VojtechNebes/ssps-stp-stenokeyboard/vystup_3/pictures/assembled_body.jpg

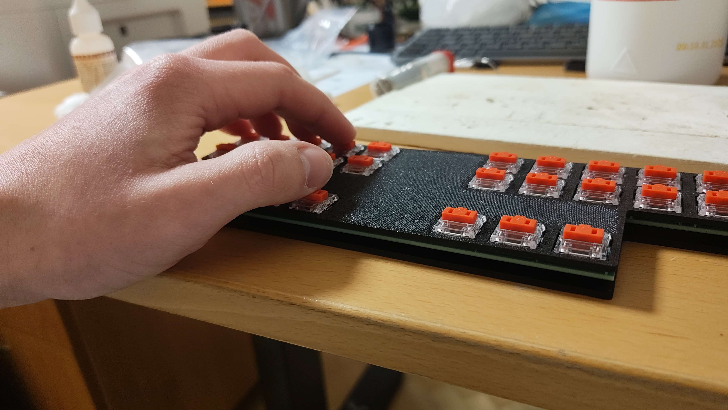
vystup_3/pictures/assembled_body.jpg
