VojtechNebes/ssps-stp-stenokeyboard/vystup_3/pictures/print_done.jpg

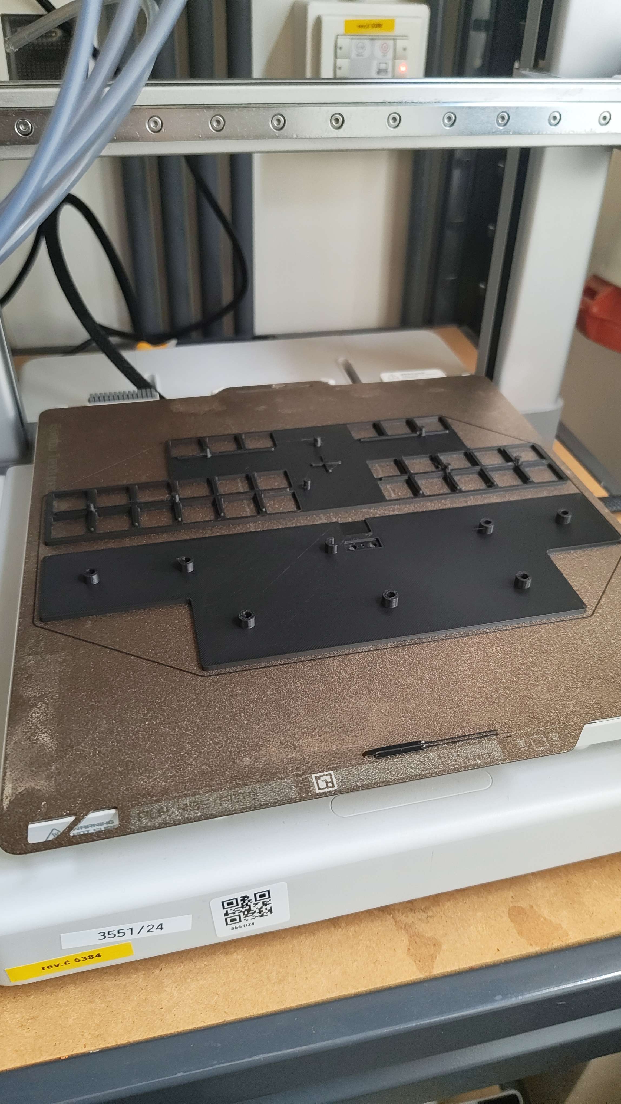
vystup_3/pictures/print_done.jpg
