VojtechNebes/ssps-stp-stenokeyboard/vystup_1/STP výstup 1.pptx

## Stenokeyboard

Výstup 1
Vojtěch Nebes, 3. A

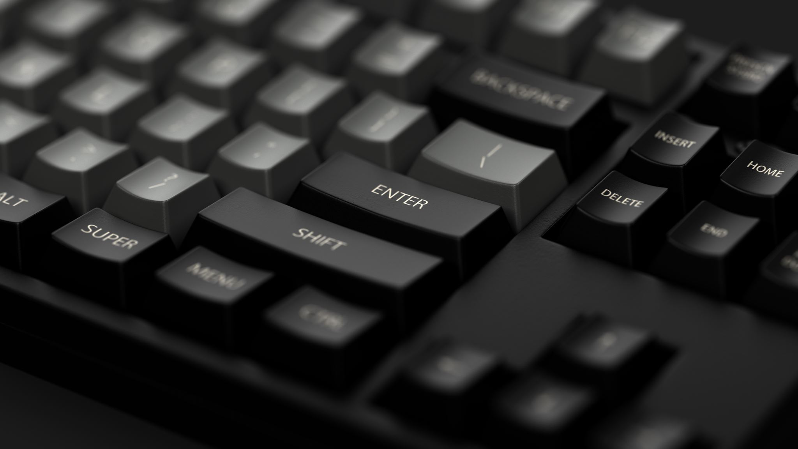
[picture p3: figure]
Closeup of a keyboard

## Obsah prvního výstupu

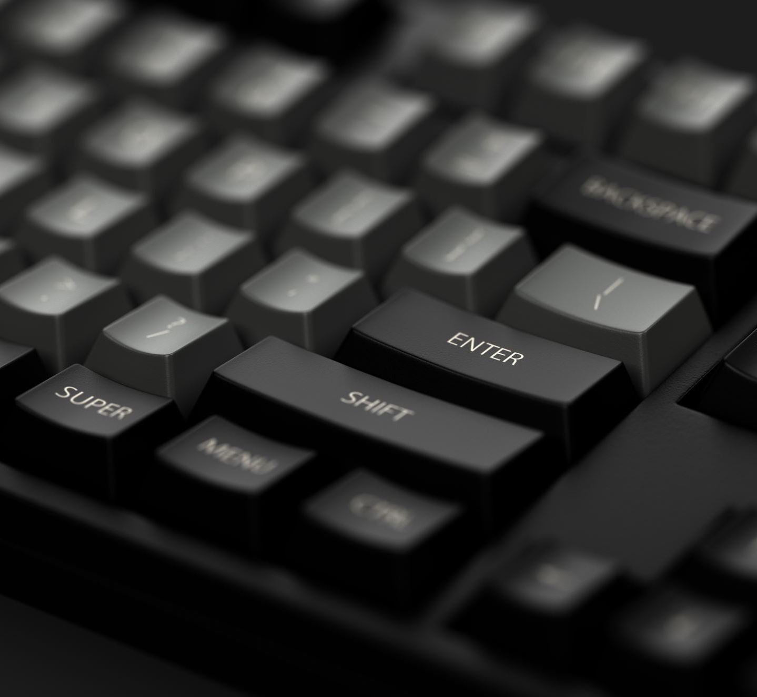
[picture p4: figure]
Closeup of a keyboard

- Nákup součástek
  - Mikrokontroler
  - Spínače
- TinyUSB prototyp
- PCB - EasyEDA

## Mikrokontroler – srdce klávesnice

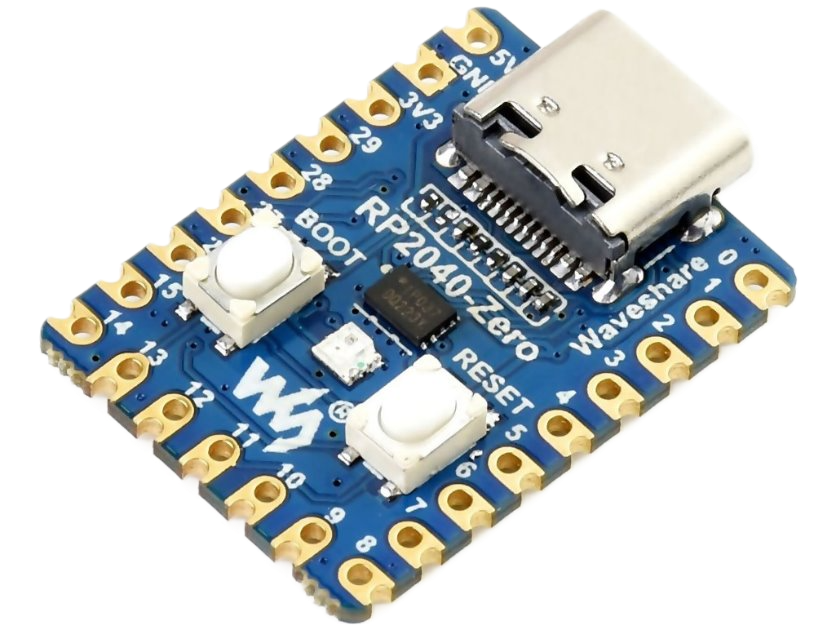
[picture p5: figure]
RP2040-Zero Module with RP2040, 2MB Flash, USB Type C - 99Tech

## Mechanické nízkoprofilové spínače

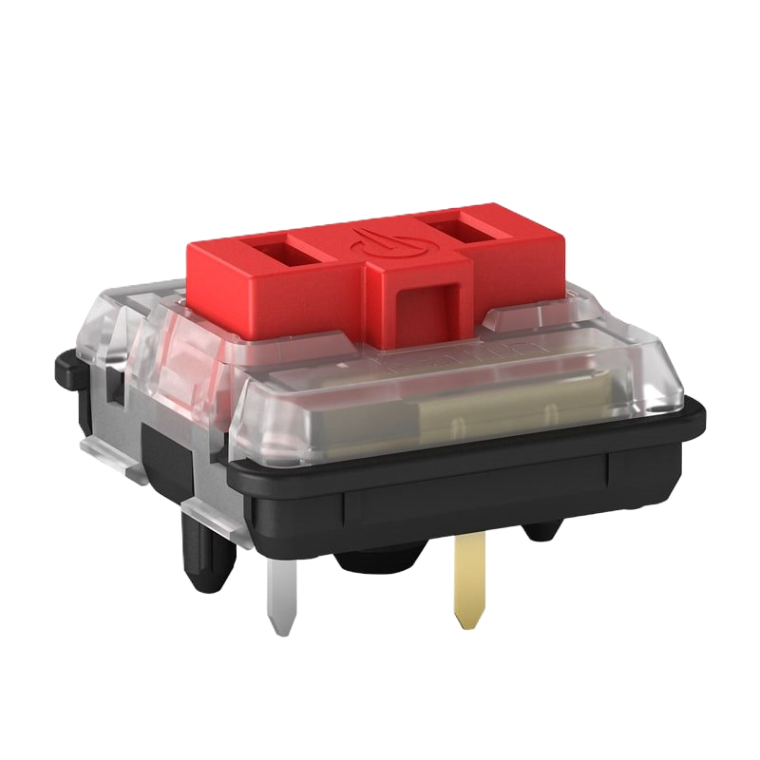
[picture p6: figure]
Kailh Low Profile Choc Switches V1 | Red | KC10034_RE

## Firmware

main.c

send_word("Hello world!\0")

my_hid.h

1. Shift H
2. E L
3. L O Space W
4. O R L D
5. Shift 1

tusb.h

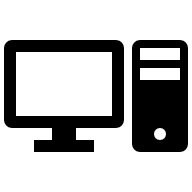
[picture p7: figure]
Computer with solid fill

## Slide 6

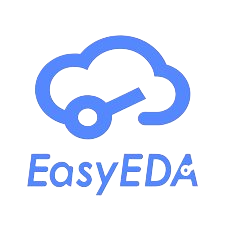
[picture p8: figure]
EasyEDA - YouTube
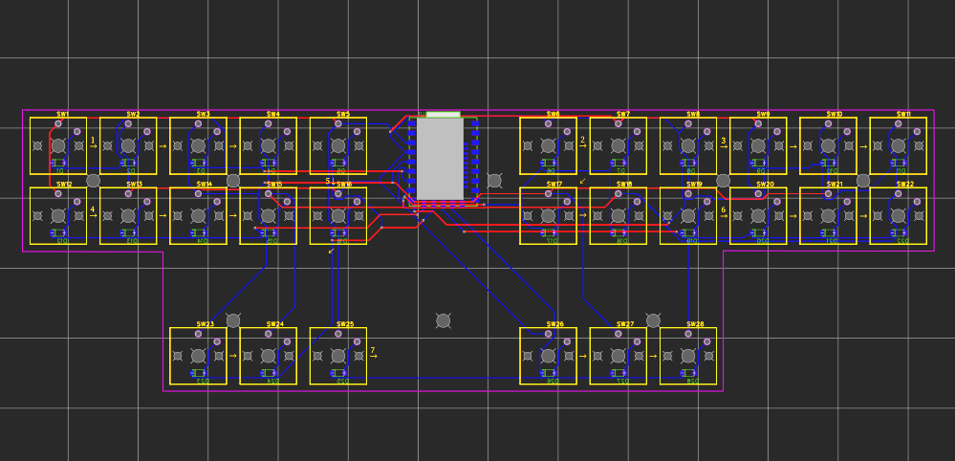
[picture p9: figure]

## Slide 7

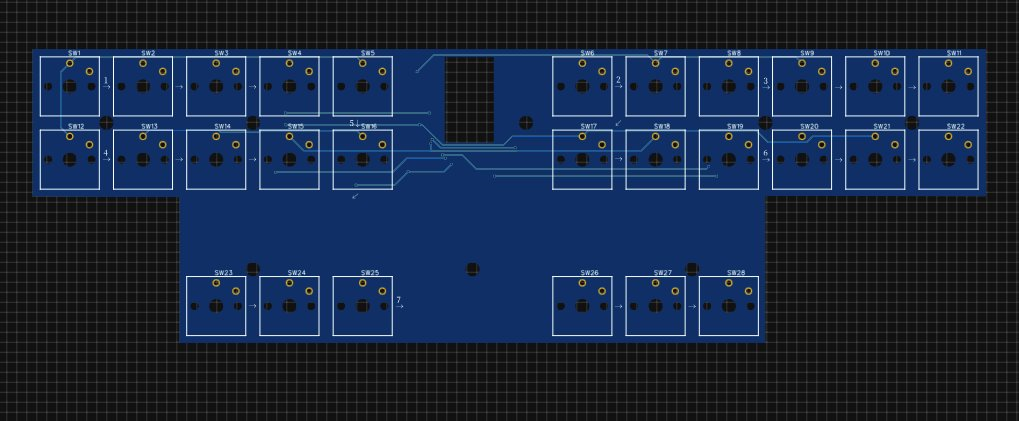
[picture p10: figure]
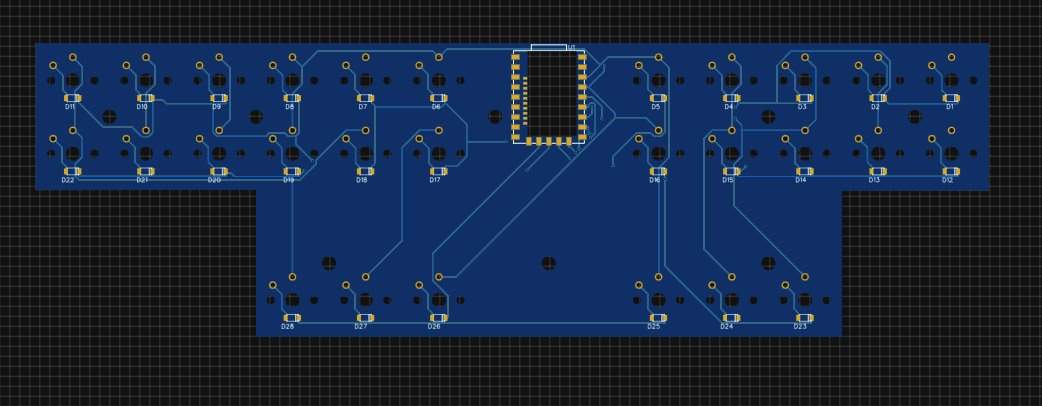
[picture p11: figure]
