VojtechNebes/ssps-stp-stenokeyboard/vystup_4/STP výstup 4.pptx

## Stenokeyboard

Výstup 4
Vojtěch Nebes, 3. A

Closeup of a keyboard

## Teorie

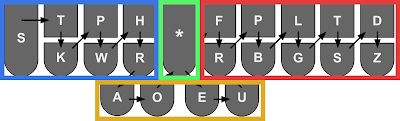
[picture p12: figure]

KAT -> "cat"

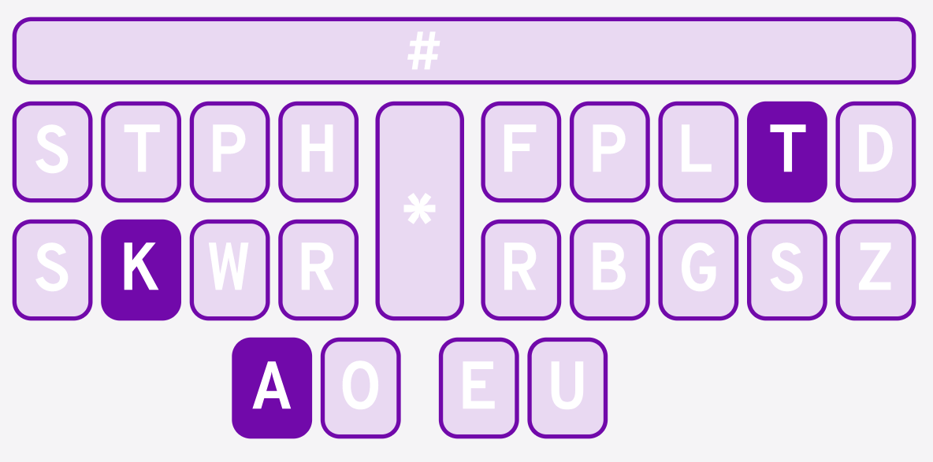
[picture p13: figure]

TKA

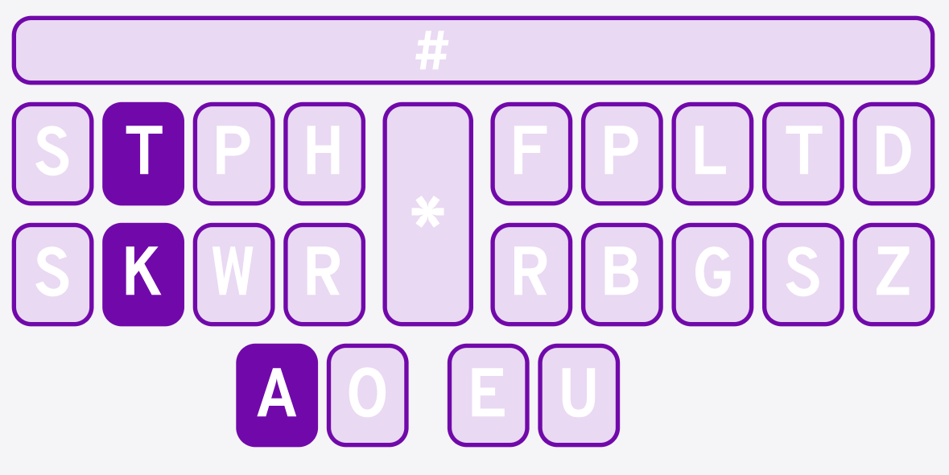
[picture p14: figure]

## Akordy

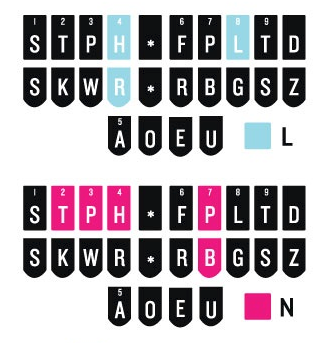
[picture p15: figure]

"long"

O

-PB

HR

-G

HRO-PBG

## Firmware???

0 1 2 3 16 4 5 8 9 10 11
12 13 14 15 17 6 7 20 21 22 23
18 19 24 26 27 28

29b 0=12, 18=28, ... 23b 3B

## Firmware???

uint_8t* hw_keyboard_scan();

chord_state: 00000000 00100100 01000000
chord_state: 00000000 00100100 00000000
+
key_state: 00000000 00000000 01000000

key_state: 00000000 00000000 01000000

## Slide 6

bool is_keyboard_empty();

true

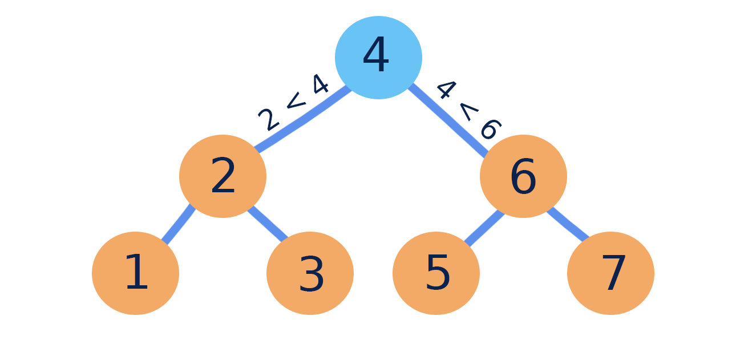
[picture p16: figure]
CS 225 | Binary Search Trees

00000000 00100100 01000000 01100011 01100001 01110100 \0 \0 \0 \0 \0 \0 \0 \0 \0 \0 \0 \0 \0 \0 \0

c

KAT

a

t

## Slide 7

void process_write(...);

## Sekvence

KPHEPBLT

"comment"

KPHEPBLT/TAER

"commentary"

SPWR/TKEUS/PHREUPB/AER

"interdisciplinary"

## py generate_dict

- JSON

{
"-T": "the",
"TO": "to",
"KAT": "cat"
}

- Binary

00000000: 40 80 00 74 6f 00 @..to.
00000006: 09 02 00 63 61 74 ...cat
0000000c: 00 02 00 74 68 65 ...the

Akord -T

"the"
