VojtechNebes/ssps-stp-stenokeyboard/vystup_2/Dokumentace výstupu 2.pdf

Smíchovská střední průmyslová škola a gymnázium – školní rok 2025/2026

# Dokumentace výstupu

### Studentský projekt:

### Řešitel:

### Číslo výstupu:

### Datum odevzdání výstupu: Popis práce na výstupu:

(100-200 slov)

### Popis příloh, které jsou součástí výstupu:

### Odkaz na sdílené úložiště (pokud je):

### Pokyny:

Každý člen týmu vyplňuje formulář sám za sebe. Popisuje svoji práci tak, aby bylo zřejmé, co

### bylo náplní jeho práce na výstupu. Pokud se popis práce shoduje s jiným členem týmu, je

nutné vysvětlit, proč je práce shodná.

### Stenokeyboard Vojt ch Nebes 2

10. 12. 2025

### V p iloženém GitHub repozitá i se nachází tento dokument a p ípadné další soubory související s výstupem

### https://github.com/VojtechNebes/ssps-stp-stenokeyboard/tree/main/vystup_2

V rámci druhého výstupu jsem navrhl a na školní 3D tiskárn vytiskl klávesové krytky pro spína e na klávesnici. K návrhu jsem použil program Autocad Inventor 2025 a pro slicování program Bambu Studio. Tiskl jsem na tiskárn Bambulab A1 z materiálu PLA. Protože mi už p išlo objednané PCB a spína e, mohl jsem rovnou otestovat r zné rozm ry klávesových krytek. Jde hlavn o to, aby dob e držely ve spína ích a aby mezi nimi byly mezery tak akorát, abych na dotek poznal hranici mezi spína i, ale ne moc velké, aby šlo snadno zmá knout víc spínačů jedním prstem. Nakonec jsem použil velikost spína e 17.1mm a toleranci pro zasazení do spína e 0.2mm.
