VojtechNebes/ssps-stp-stenokeyboard/vystup_1/Dokumentace výstupu 1.pdf

Smíchovská střední průmyslová škola a gymnázium – školní rok 2025/2026

# Dokumentace výstupu

Studentský projekt:
Řešitel:
Číslo výstupu:
Datum odevzdání výstupu:
Popis práce na výstupu:

(100-200 slov)
Popis příloh, které jsou součástí výstupu:

Odkaz na sdílené úložiště (pokud je):

Pokyny:
Každý člen týmu vyplňuje formulář sám za sebe. Popisuje svoji práci tak, aby bylo zřejmé, co bylo náplní jeho práce na výstupu. Pokud se popis práce shoduje s jiným členem týmu, je nutné vysvětlit, proč je práce shodná.

Stenokeyboard
Vojtěch Nebes
1
20. 11. 2025

V přiloženém GitHub repozitáři se nachází tento dokument, kód a případné další soubory související s výstupem

https://github.com/VojtechNebes/ssps-stp-stenokeyboard/tree/main/vystup_1

V posledních pěti týdnech jsem:
- Koupil mikrokontroler RP2040-Zero z obchodu Laskakit a objednal spínače na klávesnici z Amazonu, konkrétně Kailh Choc V1 Red, nízkoprofilové mechanické spínače, které později připájím na PCB.
- Začal pracovat na firmwaru pro mikrokontroler a rozchodil prototyp využívající knihovnu TinyUSB. Prototyp se zatím chová tak, že mikrokontroler připojím k počítači pomocí USB C kabelu. Když poté drátkem vyskratuji konkrétní 2 GPIO piny (drátek bude později nahrazen spínačem klávesnice), na připojeném počítači se napíše řetězec "Hello world!".
- Navrhl PCB v programu EasyEda, nicméně tam ještě bude potřeba další práce, než ho pošlu k výrobě. Je třeba domyslet připevnění PCB k tělu klávesnice - jestli použiji šroubky, nebo lepidlo.
