VojtechNebes/ssps-stp-stenokeyboard/vystup_1/pictures/PCB_design.png

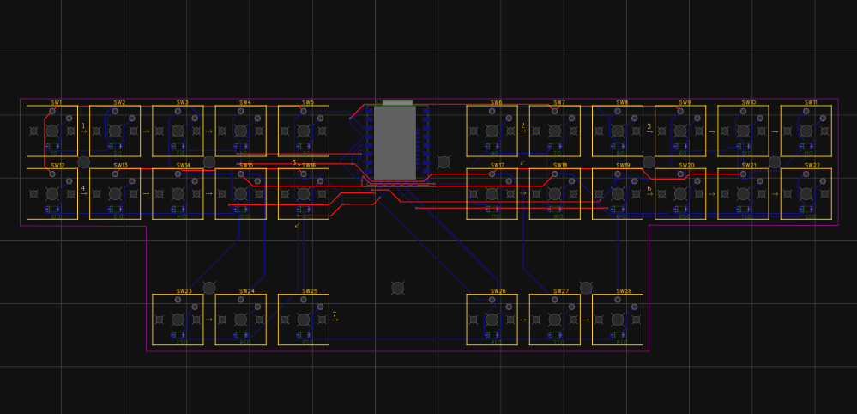
vystup_1/pictures/PCB_design.png
