VojtechNebes/ssps-stp-stenokeyboard/vystup_1/pictures/PCB_preview_top.png

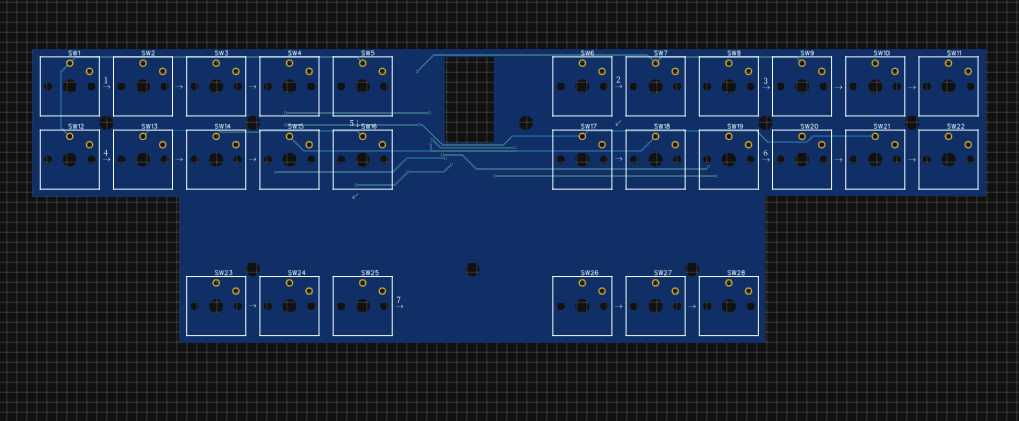
vystup_1/pictures/PCB_preview_top.png
