VojtechNebes/ssps-stp-stenokeyboard/vystup_2/pictures/key_in_pcb.jpg

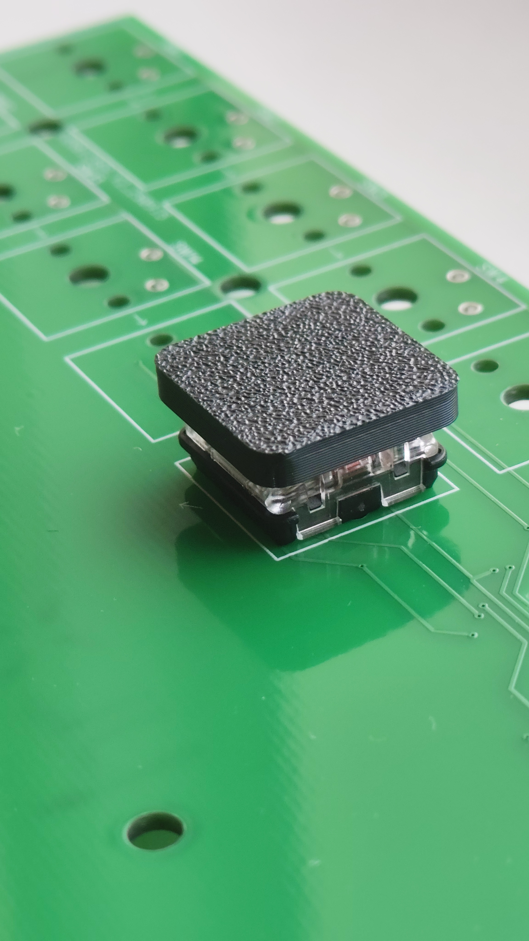
vystup_2/pictures/key_in_pcb.jpg
