VojtechNebes/ssps-stp-stenokeyboard/vystup_2/pictures/key_pressed.jpg

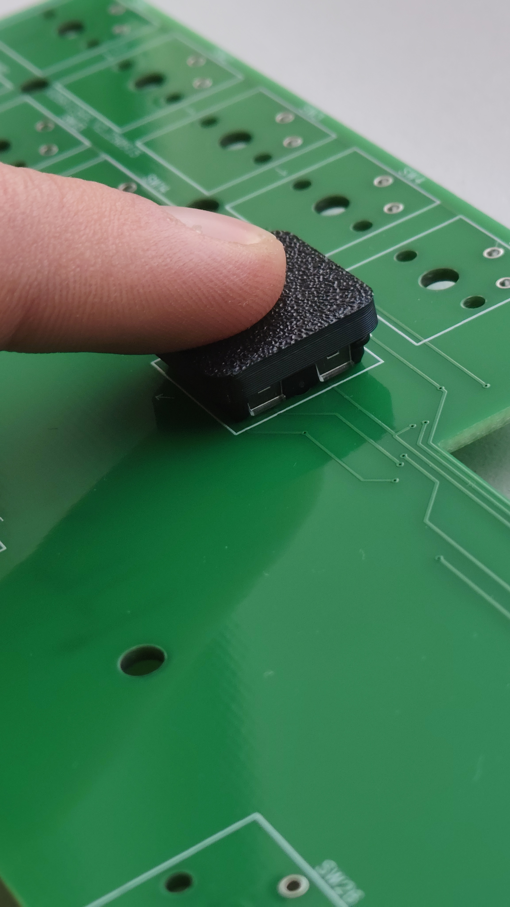
vystup_2/pictures/key_pressed.jpg
