VojtechNebes/ssps-stp-stenokeyboard/vystup_2/pictures/key_released.jpg

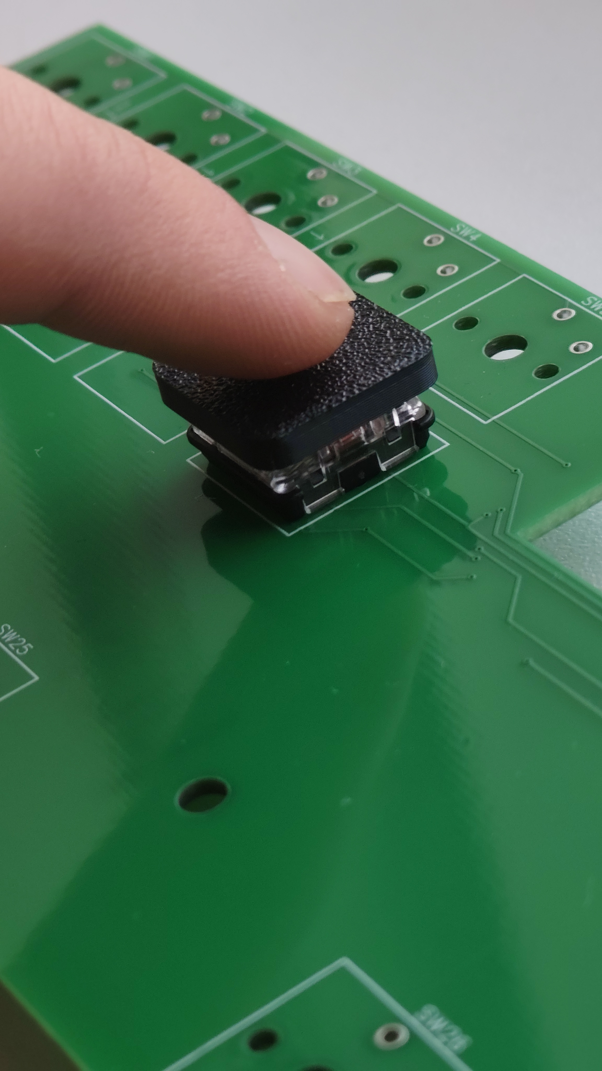
vystup_2/pictures/key_released.jpg
