VojtechNebes/ssps-stp-stenokeyboard/vystup_2/pictures/keycap_bottom.jpg

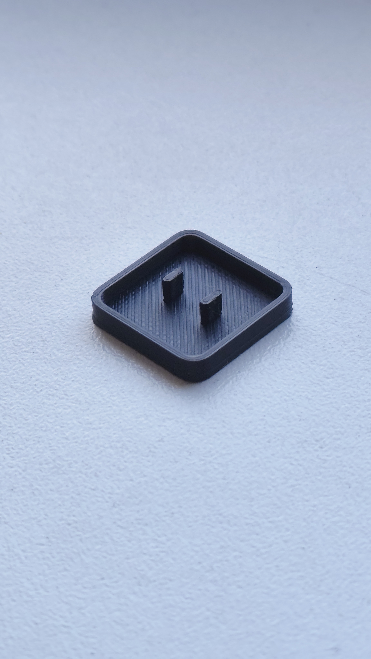
vystup_2/pictures/keycap_bottom.jpg
