VojtechNebes/ssps-stp-stenokeyboard/vystup_2/pictures/keycap_inventor.png

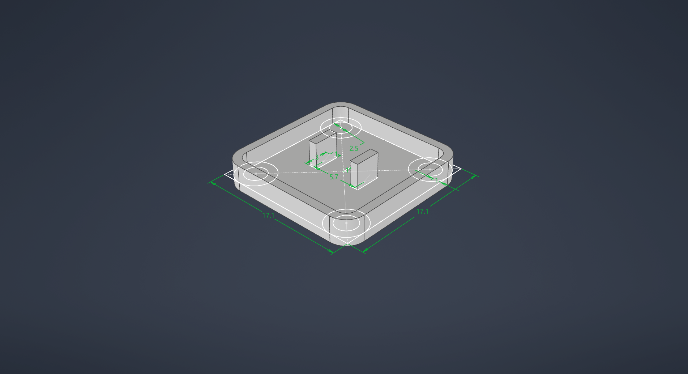
vystup_2/pictures/keycap_inventor.png
