VojtechNebes/ssps-stp-stenokeyboard/vystup_2/pictures/keycap_on_switch.jpg

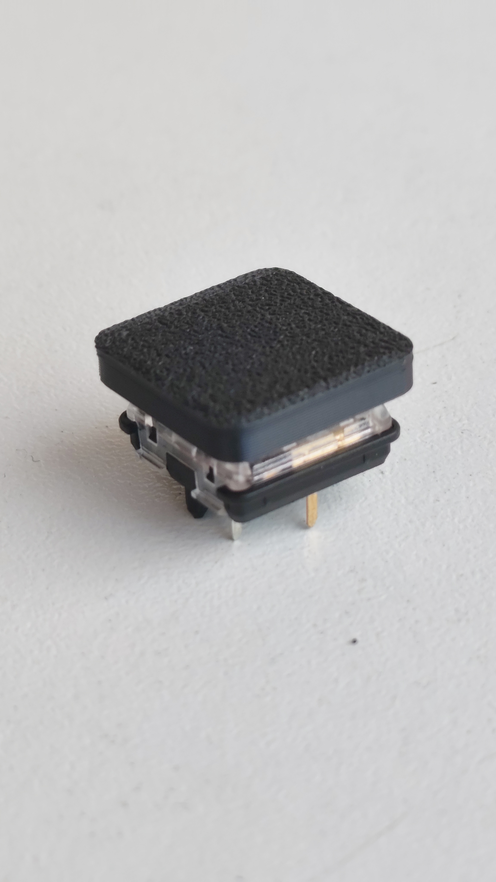
vystup_2/pictures/keycap_on_switch.jpg
