VojtechNebes/ssps-stp-stenokeyboard/vystup_2/pictures/keycap_slicer.png

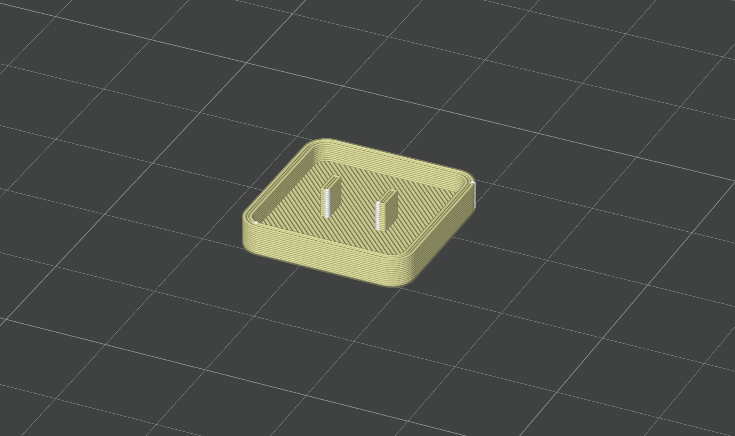
vystup_2/pictures/keycap_slicer.png
