VojtechNebes/ssps-stp-stenokeyboard/vystup_2/pictures/keycap_top.jpg

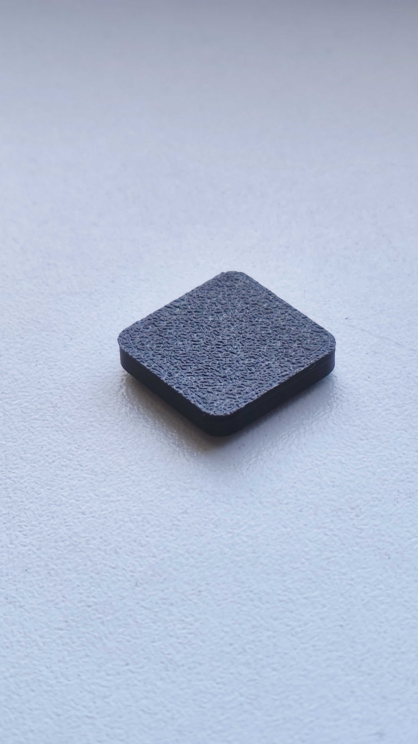
vystup_2/pictures/keycap_top.jpg
