VojtechNebes/ssps-stp-stenokeyboard/vystup_2/pictures/pcb_bottom.jpg

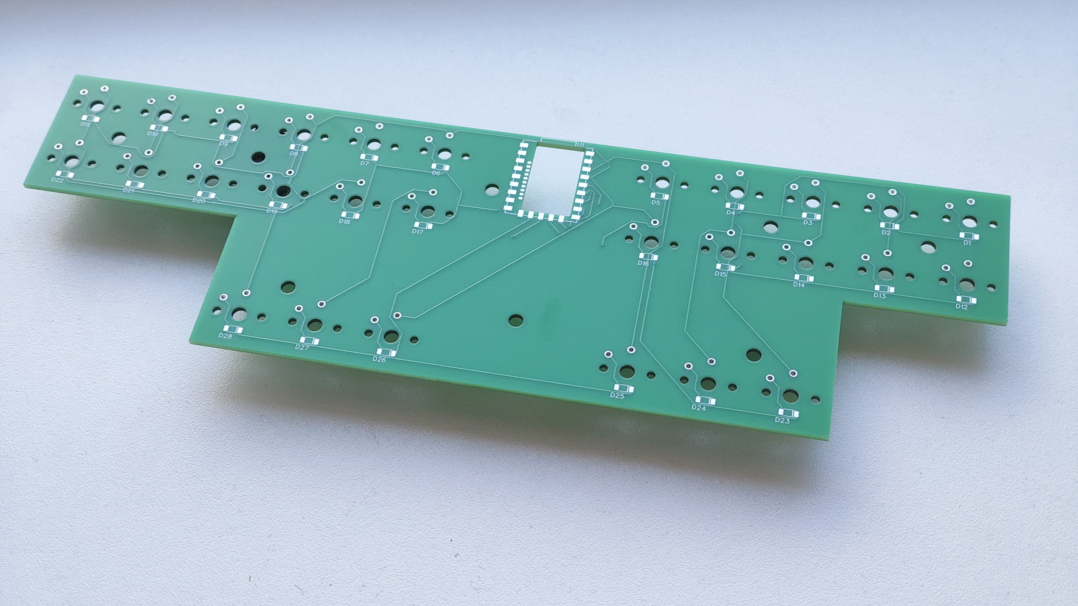
vystup_2/pictures/pcb_bottom.jpg
