VojtechNebes/ssps-stp-stenokeyboard/vystup_2/pictures/pcb_close_up.jpg

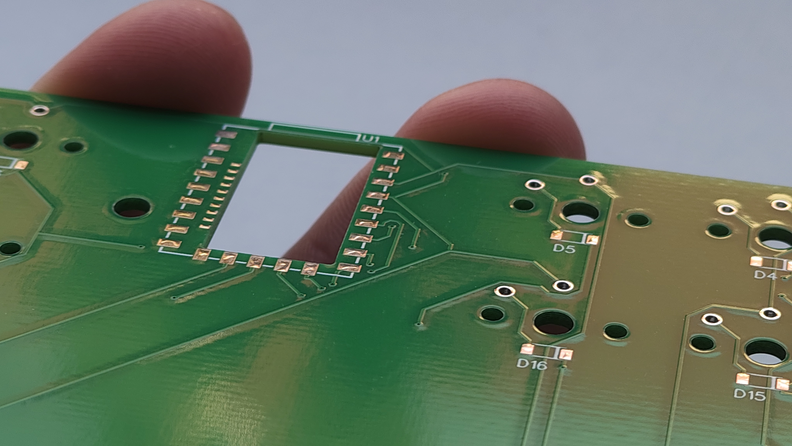
vystup_2/pictures/pcb_close_up.jpg
