VojtechNebes/ssps-stp-stenokeyboard/vystup_2/pictures/pcb_top.jpg

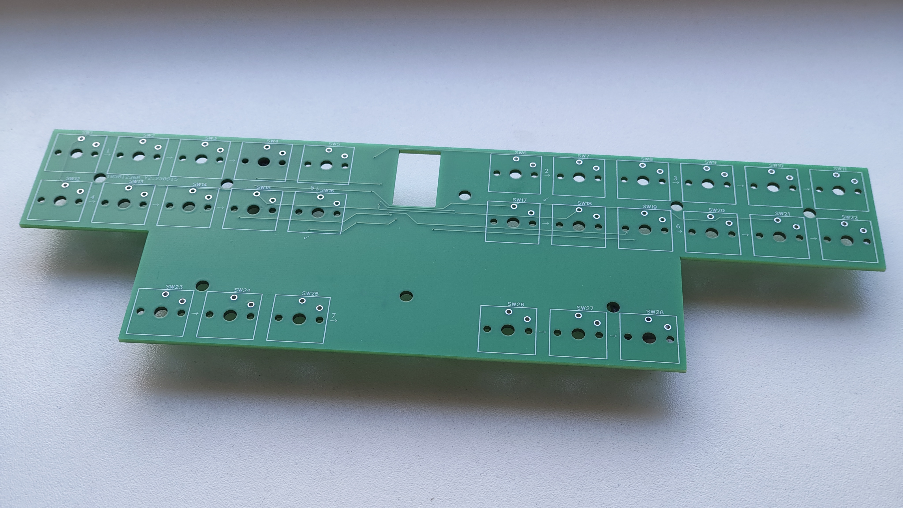
vystup_2/pictures/pcb_top.jpg
