VojtechNebes/ssps-stp-stenokeyboard/vystup_2/pictures/switch.jpg

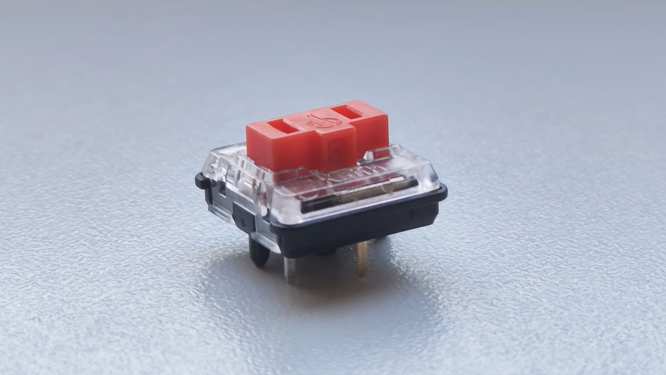
vystup_2/pictures/switch.jpg
