VojtechNebes/ssps-stp-stenokeyboard/vystup_2/pictures/switch_in_pcb.jpg

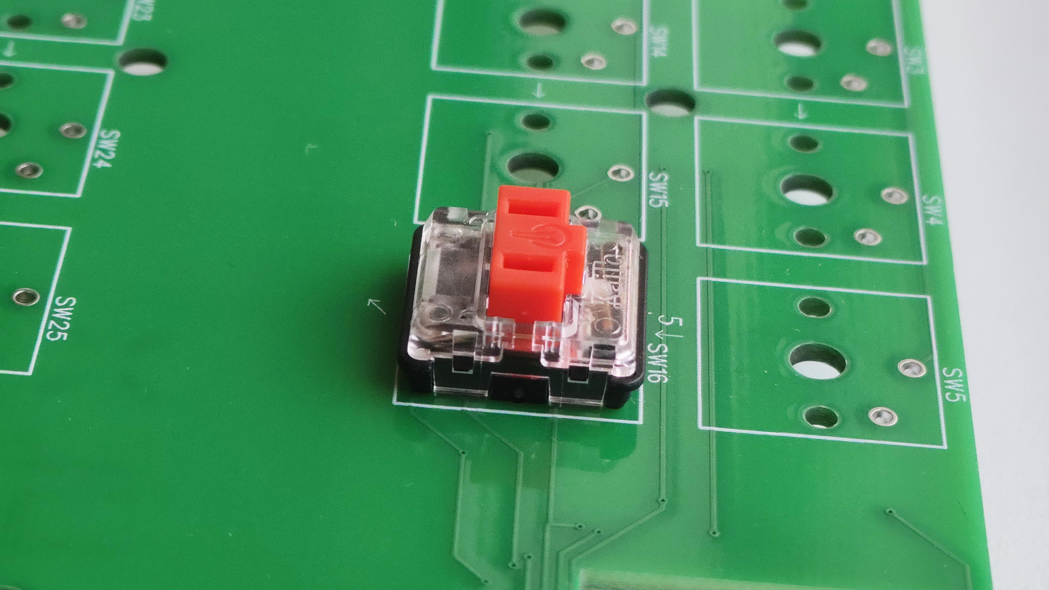
vystup_2/pictures/switch_in_pcb.jpg
