VojtechNebes/ssps-stp-stenokeyboard/vystup_2/pictures/switch_in_pcb_bottom.jpg

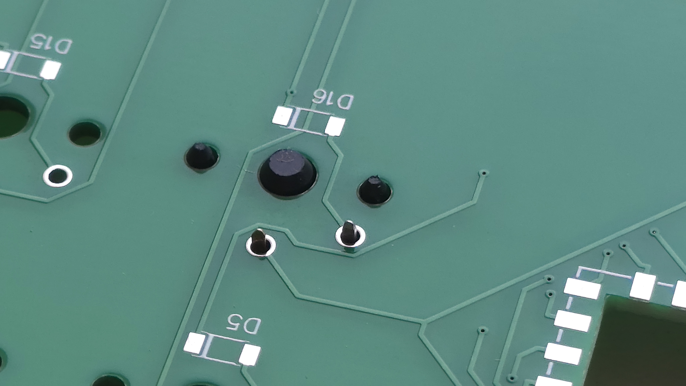
vystup_2/pictures/switch_in_pcb_bottom.jpg
