VojtechNebes/ssps-stp-stenokeyboard/vystup_2/models/keycap.stl

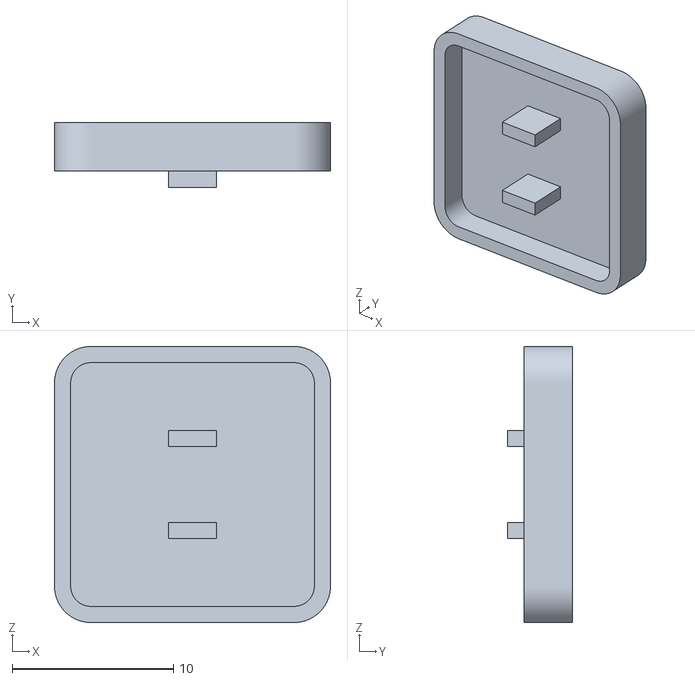
[picture p38: CAD file, 2025-12-10]
vystup_2/models/keycap.stl
17.1 x 4.00 x 17.1
