VojtechNebes/ssps-stp-stenokeyboard/(list of files, cad)

Other CAD files:
vystup_2/models/keycap.ipt
