VojtechNebes/ssps-stp-stenokeyboard/vystup_3/pictures/assembled_body_from_side.jpg

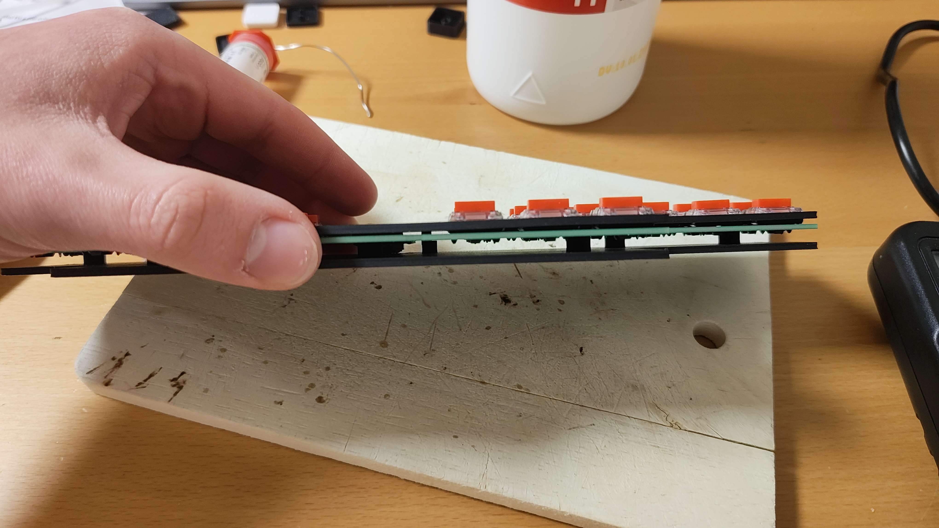
vystup_3/pictures/assembled_body_from_side.jpg
