VojtechNebes/ssps-stp-stenokeyboard/vystup_3/pictures/print_length.jpg

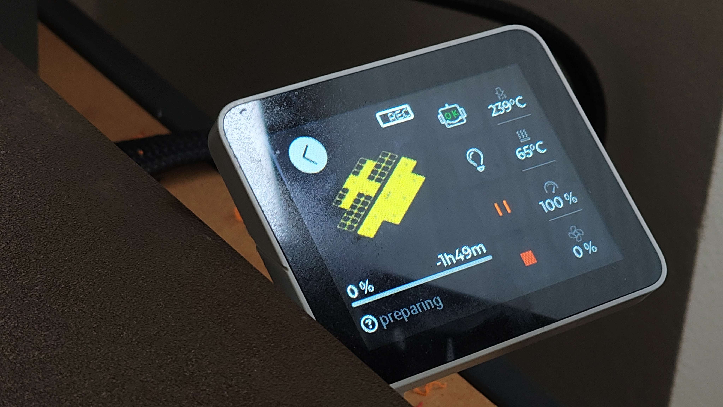
vystup_3/pictures/print_length.jpg
