VojtechNebes/ssps-stp-stenokeyboard/vystup_3/pictures/print_process.jpg

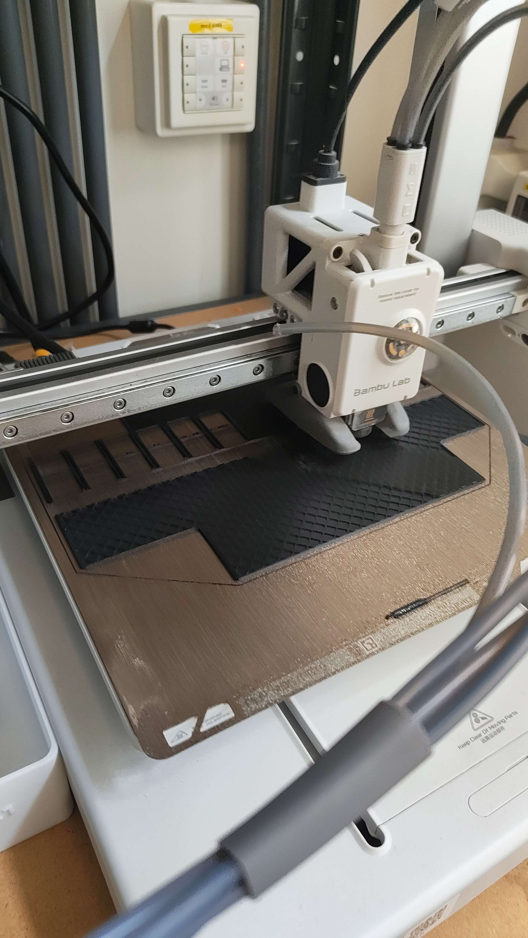
vystup_3/pictures/print_process.jpg
