VojtechNebes/ssps-stp-stenokeyboard/vystup_4/src/tusb_config.h

#ifndef _TUSB_CONFIG_H_
#define _TUSB_CONFIG_H_

#ifdef __cplusplus
extern "C" {
#endif

//--------------------------------------------------------------------
// Common Configuration
//--------------------------------------------------------------------
#define CFG_TUSB_MCU                OPT_MCU_RP2040
// #define CFG_TUSB_OS                 OPT_OS_NONE
#define CFG_TUSB_RHPORT0_MODE       (OPT_MODE_DEVICE | OPT_MODE_FULL_SPEED)
#define CFG_TUSB_MEM_SECTION
#define CFG_TUSB_MEM_ALIGN          __attribute__ ((aligned(4)))

//--------------------------------------------------------------------
// Device Configuration
//--------------------------------------------------------------------
#define CFG_TUD_ENDPOINT0_SIZE      64

//--------------------------------------------------------------------
// Class Configuration
//--------------------------------------------------------------------
#define CFG_TUD_HID                 1   // one HID interface
#define CFG_TUD_CDC                 1
#define CFG_TUD_MSC                 0
#define CFG_TUD_MIDI                0
#define CFG_TUD_VENDOR              0

// HID buffer size
#define CFG_TUD_HID_EP_BUFSIZE      16

// CDC FIFO buffer sizes (bytes)
#define CFG_TUD_CDC_RX_BUFSIZE    64
#define CFG_TUD_CDC_TX_BUFSIZE    64

#ifdef __cplusplus
}
#endif

#endif /* _TUSB_CONFIG_H_ */
